antonpatino/2DOF-TVC-Rocket-Controller/(commit log)

2026-03-05 Update LQR gains, adjust servo pin assignments
2026-03-14 Fix angle calculations using accelerometer and gyroscope
    [LQR.ino]
